pluggee/R1005/README.md

# R1005
General Purpose Breakout/Extension for Juicyboard platform

# License
R1005 is released under the GNU GPL v3, which you can find at <http://www.gnu.org/licenses/gpl-3.0.en.html>,
Check License.md for more details.
