pluggee/R1005/pcb/R1005_BOM.ods

Reference | Value | Footprint | Datasheet | Manufacturer | MPN | SKU
J2 | CONN_R1000A_EXTENSION | Main:CONN127P-02X10 |  | CNC Tech | 3221-20-0200-00 | GENERIC
