pluggee/R1005/(commit log)

2016-07-30 first commit, releasing schematics and layout
    [R1005-B.Cu.gbr, R1005-B.Mask.gbr, R1005-B.Paste.gbr, R1005-B.SilkS.gbr, R1005-Edge.Cuts.gbr, R1005-F.Cu.gbr, R1005-F.Mask.gbr, R1005-F.Paste.gbr]
2016-08-19 added BOM
    [R1005_BOM.csv]
2016-12-13 ready for 1.0.1 release
    [R1005-B.Cu.gbr, R1005-B.Mask.gbr, R1005-B.Paste.gbr, R1005-B.SilkS.gbr, R1005-Edge.Cuts.gbr, R1005-F.Cu.gbr, R1005-F.Mask.gbr, R1005-F.Paste.gbr]
2016-12-13 added slots for zip ties
    [R1005-B.Cu.gbr, R1005-B.Mask.gbr, R1005-B.Paste.gbr, R1005-B.SilkS.gbr, R1005-Edge.Cuts.gbr, R1005-F.Cu.gbr, R1005-F.Mask.gbr, R1005-F.Paste.gbr]
2017-03-31 updated pcb for crowdsupply release
    [R1005-B.Cu.gbr, R1005-B.Mask.gbr, R1005-B.Paste.gbr, R1005-B.SilkS.gbr, R1005-Edge.Cuts.gbr, R1005-F.Cu.gbr, R1005-F.Mask.gbr, R1005-F.Paste.gbr]
2017-04-16 re-exported gerbers
    [R1005-B.Cu.gbr, R1005-B.Mask.gbr, R1005-B.Paste.gbr, R1005-B.SilkS.gbr, R1005-Edge.Cuts.gbr, R1005-F.Cu.gbr, R1005-F.Mask.gbr, R1005-F.Paste.gbr]
2017-04-16 fixed 3D model of connector
    [R1005-B.Cu.gbr, R1005-B.Mask.gbr, R1005-B.Paste.gbr, R1005-B.SilkS.gbr, R1005-Edge.Cuts.gbr, R1005-F.Cu.gbr, R1005-F.Mask.gbr, R1005-F.Paste.gbr]
2017-04-16 fixed silk screen release #
    [R1005-B.Cu.gbr, R1005-B.Mask.gbr, R1005-B.Paste.gbr, R1005-B.SilkS.gbr, R1005-Edge.Cuts.gbr, R1005-F.Cu.gbr, R1005-F.Mask.gbr, R1005-F.Paste.gbr]
